osseus-mvp/asimov-1/electrical/README.md

## RPU 
> WIP

## Wiring

WireViz was utilised for representing the wiring harness of the robot. 

Please refer to WireViz documentation for available visualisation options.
### Cable Naming Convention

```
W-<ID>-<TYPE>
ID = unique ID
TYPE = Power (PWR) or Signal (SIG) cable bundle
```
