osseus-mvp/asimov-1/electrical/motion_control/board/MCB-V1.0.step

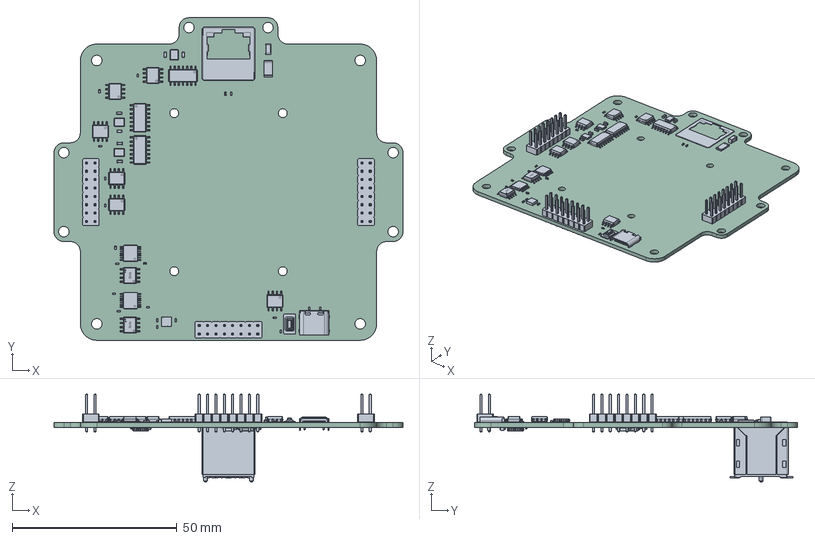
[picture p1: CAD file, 2026-07-03]
electrical/motion_control/board/MCB-V1.0.step
106.0 x 98.0 x 26.7 mm
R_0402_1005Metric x 13
SOIC-8_3.9x4.9mm_P1.27mm x 6
SOIC-14_3.9x8.7mm_P1.27mm x 3
C_0603_1608Metric x 6
SW-SMD_L6.2-W3.7-LS8.0
C_0402_1005Metric x 15
SOIC-8_L4.9-W3.9-H1.7-LS6.0-P1.27 x 2
PinHeader_2x08_P2.54mm_Vertical x 3
C_1206_3216Metric
USB-C-SMD_TYPE-C-6PIN-2MD-073
TSSOP-14_4.4x5mm_P0.65mm x 4
R_2010_5025Metric
DFN-8_L3.0-W3.0-H1.0-P0.50
Crystal_SMD_3225-4Pin_3.2x2.5mm x 3
RJ45-SMD_HR963380AE
LGA-14_L2.5-W3.0-H0.9-P0.50
board_PCB
