osseus-mvp/asimov-1/electrical/power_distribution/board/PDB-V1.0.step

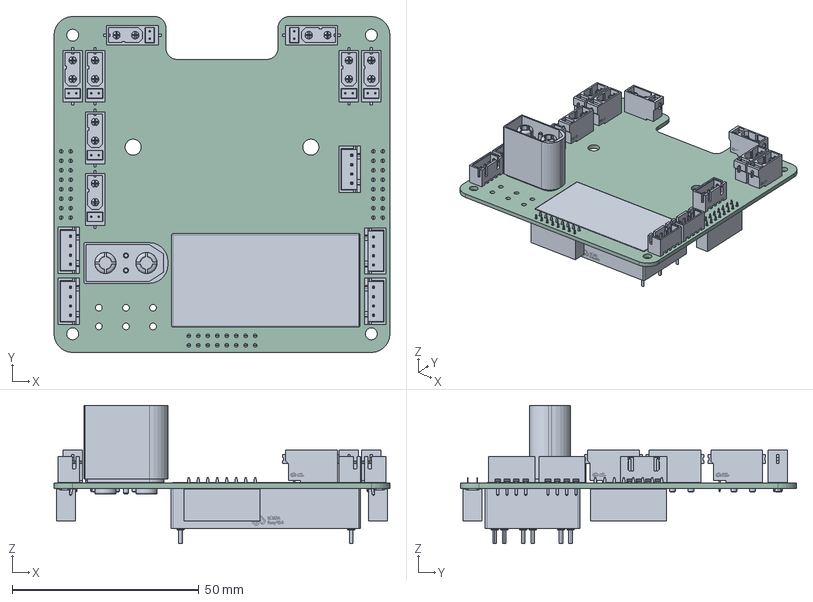
[picture p2: CAD file, 2026-07-03]
electrical/power_distribution/board/PDB-V1.0.step
90.0 x 90.0 x 37.0 mm
CONN-SMD_XT90-2-2-PB-MGY
CONN-TH_XT30PB-M x 8
JST_XH_B4B-XH-A_1x04_P2.50mm_Vertical x 5
PWRM-TH_TURBXXXXLD-30WR3
PinSocket_2x08_P2.54mm_Vertical x 3
board_PCB
