osseus-mvp/asimov-1/sim-model/assets/meshes/ANKLE_B_NEW.STL

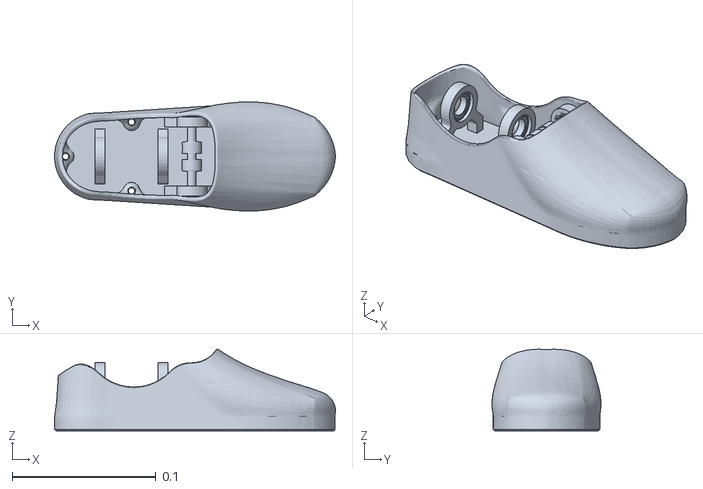
[picture p3: CAD file, 2026-08-17]
sim-model/assets/meshes/ANKLE_B_NEW.STL
0.196 x 0.0761 x 0.0569
