osseus-mvp/asimov-1/(list of files, drawings)

Other design files:
electrical/head_board/head_board.epro
