osseus-mvp/asimov-1/electrical/power_distribution/board/board.kicad_pcb

## KiCad design electrical/power_distribution/board/board.kicad_pcb (2026-07-03)

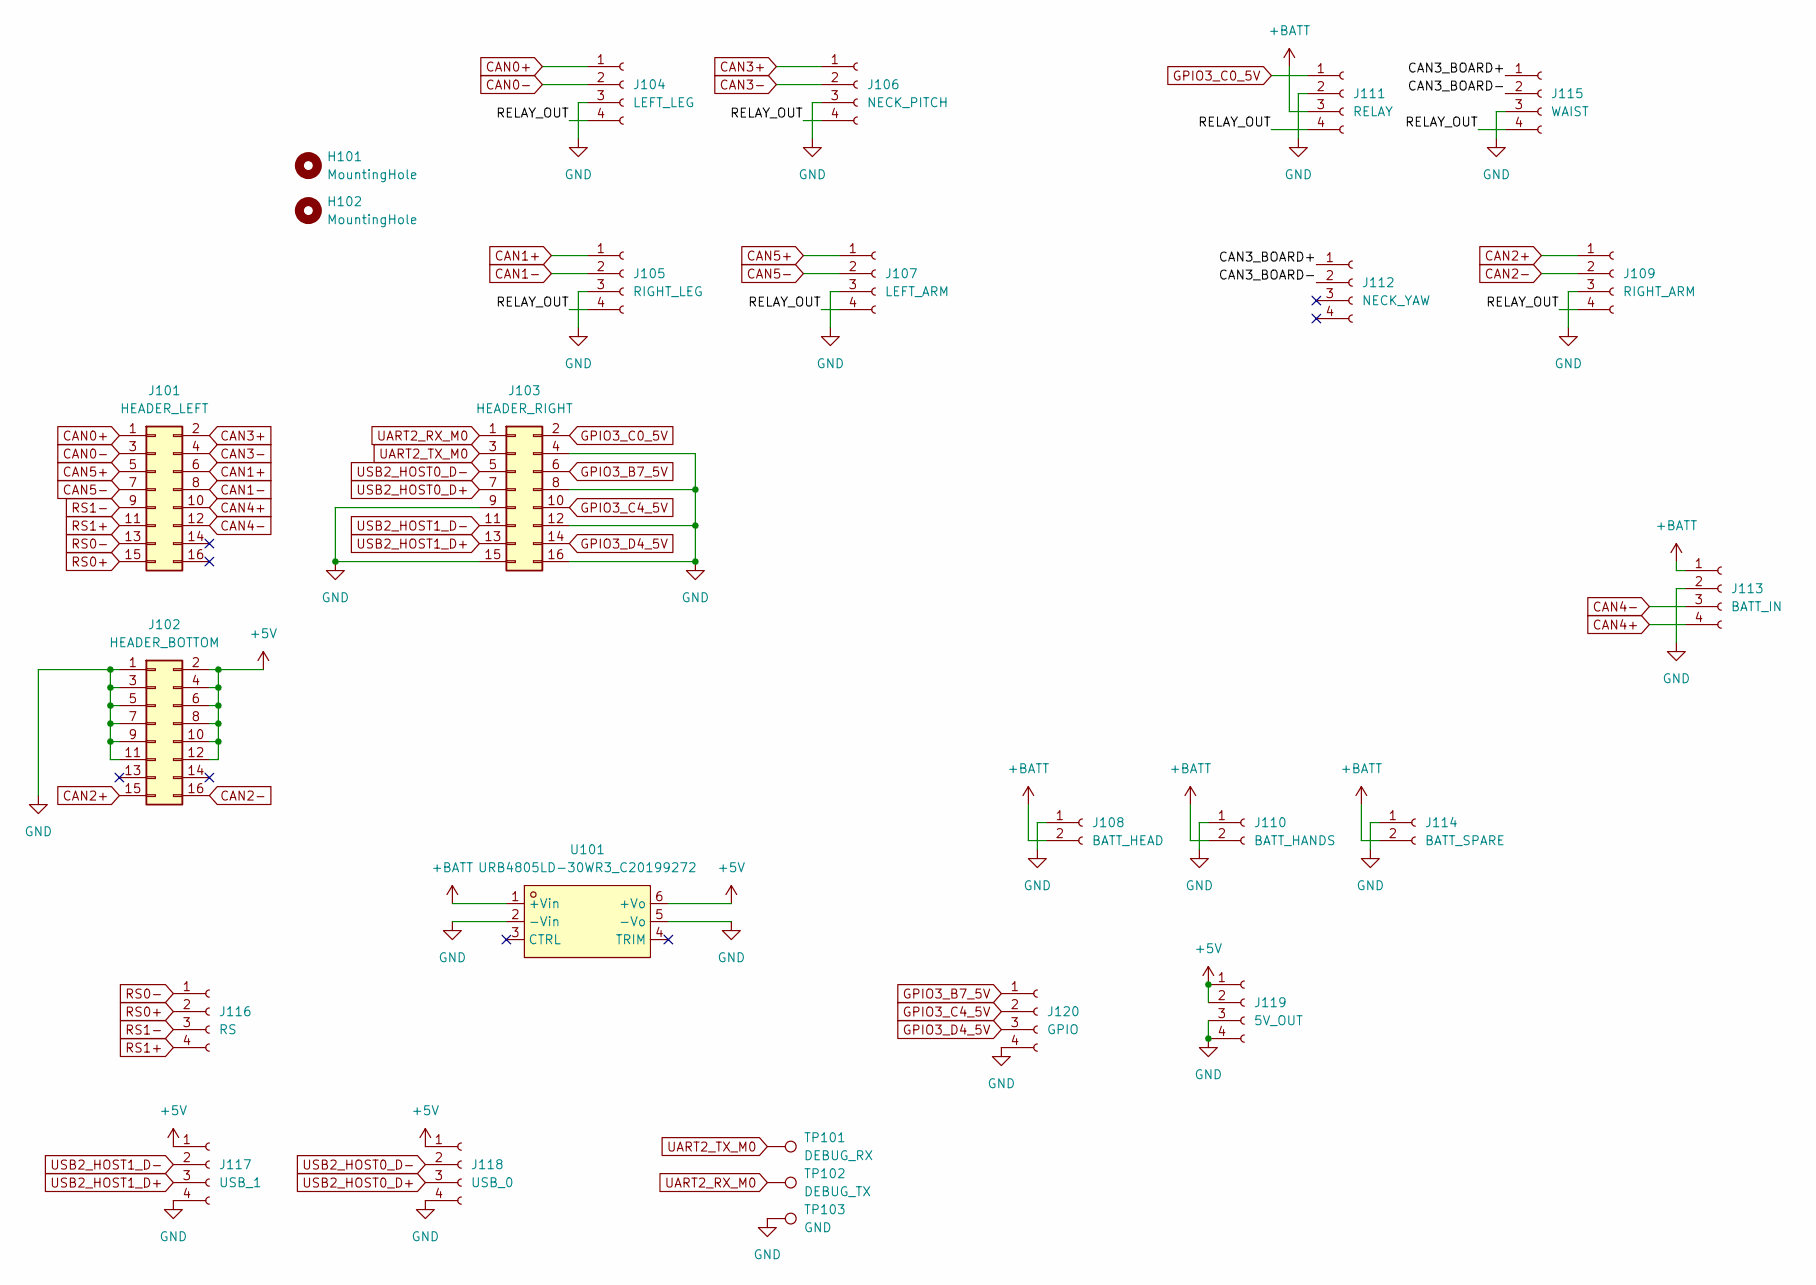
[picture p4: schematic board.kicad_sch]

Parts:
H101, H102: MountingHole; MountingHole_4.3mm_M4
J101: HEADER_LEFT; PinSocket_2x08_P2.54mm_Vertical; LCSC C30734
J102: HEADER_BOTTOM; PinSocket_2x08_P2.54mm_Vertical; LCSC C30734
J103: HEADER_RIGHT; PinSocket_2x08_P2.54mm_Vertical; LCSC C30734
J104: LEFT_LEG; CONN-TH_XT30PB-M
J105: RIGHT_LEG; CONN-TH_XT30PB-M
J106: NECK_PITCH; CONN-TH_XT30PB-M
J107: LEFT_ARM; CONN-TH_XT30PB-M
J108: BATT_HEAD; AMASS_XT30UPB-F_1x02_P5.0mm_Vertical; LCSC C108769
J109: RIGHT_ARM; CONN-TH_XT30PB-M
J110: BATT_HANDS; AMASS_XT30UPB-F_1x02_P5.0mm_Vertical; LCSC C108769
J111: RELAY; CONN-TH_XT30PB-M
J112: NECK_YAW; CONN-TH_XT30PB-M
J113: BATT_IN; CONN-SMD_XT90-2-2-PB-MGY; LCSC C19268046
J114: BATT_SPARE; AMASS_XT30UPB-F_1x02_P5.0mm_Vertical; LCSC C108769
J115: WAIST; CONN-TH_XT30PB-M
J116: RS; JST_XH_B4B-XH-A_1x04_P2.50mm_Vertical; LCSC C144395
J117: USB_1; JST_XH_B4B-XH-A_1x04_P2.50mm_Vertical; LCSC C144395
J118: USB_0; JST_XH_B4B-XH-A_1x04_P2.50mm_Vertical; LCSC C144395
J119: 5V_OUT; JST_XH_B4B-XH-A_1x04_P2.50mm_Vertical; LCSC C144395
J120: GPIO; JST_XH_B4B-XH-A_1x04_P2.50mm_Vertical; LCSC C144395
TP101: DEBUG_RX; TestPoint_Pad_D1.0mm
TP102: DEBUG_TX; TestPoint_Pad_D1.0mm
TP103: GND; TestPoint_Pad_D1.0mm
U101: URB4805LD-30WR3_C20199272; PWRM-TH_TURBXXXXLD-30WR3; MPN URB4805LD-30WR3; LCSC Part C20199272

Connections:
+5V: J102.2, J102.4, J102.6, J102.8, J102.10, J102.12, J117.1, J118.1, J119.1, J119.2, U101.6 (+Vo)
+BATT: J108.2, J110.2, J111.3, J113.1, J114.2, U101.1 (+Vin)
/CAN3_BOARD+: J112.1, J115.1
/CAN3_BOARD-: J112.2, J115.2
/RELAY_OUT: J104.4, J105.4, J106.4, J107.4, J109.4, J111.4, J115.4
CAN0+: J101.1, J104.1
CAN0-: J101.3, J104.2
CAN1+: J101.6, J105.1
CAN1-: J101.8, J105.2
CAN2+: J102.15, J109.1
CAN2-: J102.16, J109.2
CAN3+: J101.2, J106.1
CAN3-: J101.4, J106.2
CAN4+: J101.10, J113.4
CAN4-: J101.12, J113.3
CAN5+: J101.5, J107.1
CAN5-: J101.7, J107.2
GND: J102.1, J102.3, J102.5, J102.7, J102.9, J102.11, J103.4, J103.8, J103.9, J103.12, J103.15, J103.16, J104.3, J105.3, J106.3, J107.3, J108.1, J109.3, J110.1, J111.2, J113.2, J114.1, J115.3, J117.4, J118.4, J119.3, J119.4, J120.4, TP103.1 (1_1), U101.2 (-Vin), U101.5 (-Vo)
GPIO3_B7_5V: J103.6, J120.1
GPIO3_C0_5V: J103.2, J111.1
GPIO3_C4_5V: J103.10, J120.2
GPIO3_D4_5V: J103.14, J120.3
RS0+: J101.15, J116.2
RS0-: J101.13, J116.1
RS1+: J101.11, J116.4
RS1-: J101.9, J116.3
UART2_RX_M0: J103.1, TP102.1 (1_1)
UART2_TX_M0: J103.3, TP101.1 (1_1)
USB2_HOST0_D+: J103.7, J118.3
USB2_HOST0_D-: J103.5, J118.2
USB2_HOST1_D+: J103.13, J117.3
USB2_HOST1_D-: J103.11, J117.2

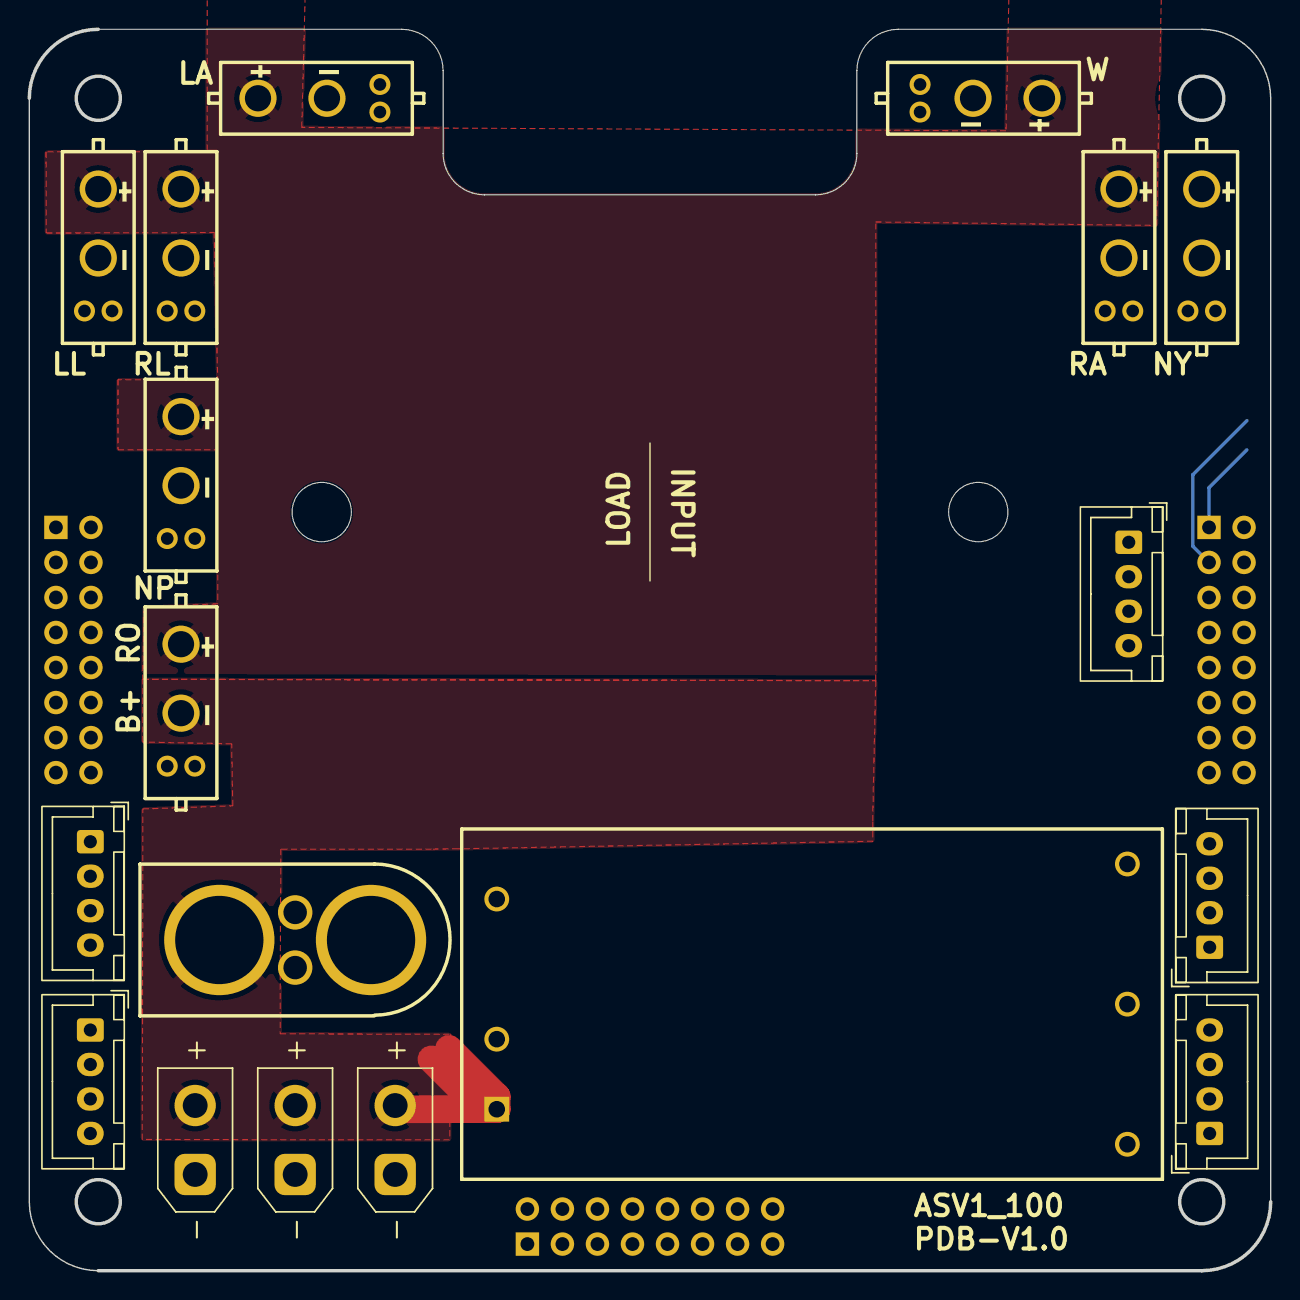
[picture p5: board electrical/power_distribution/board/board.kicad_pcb from above]

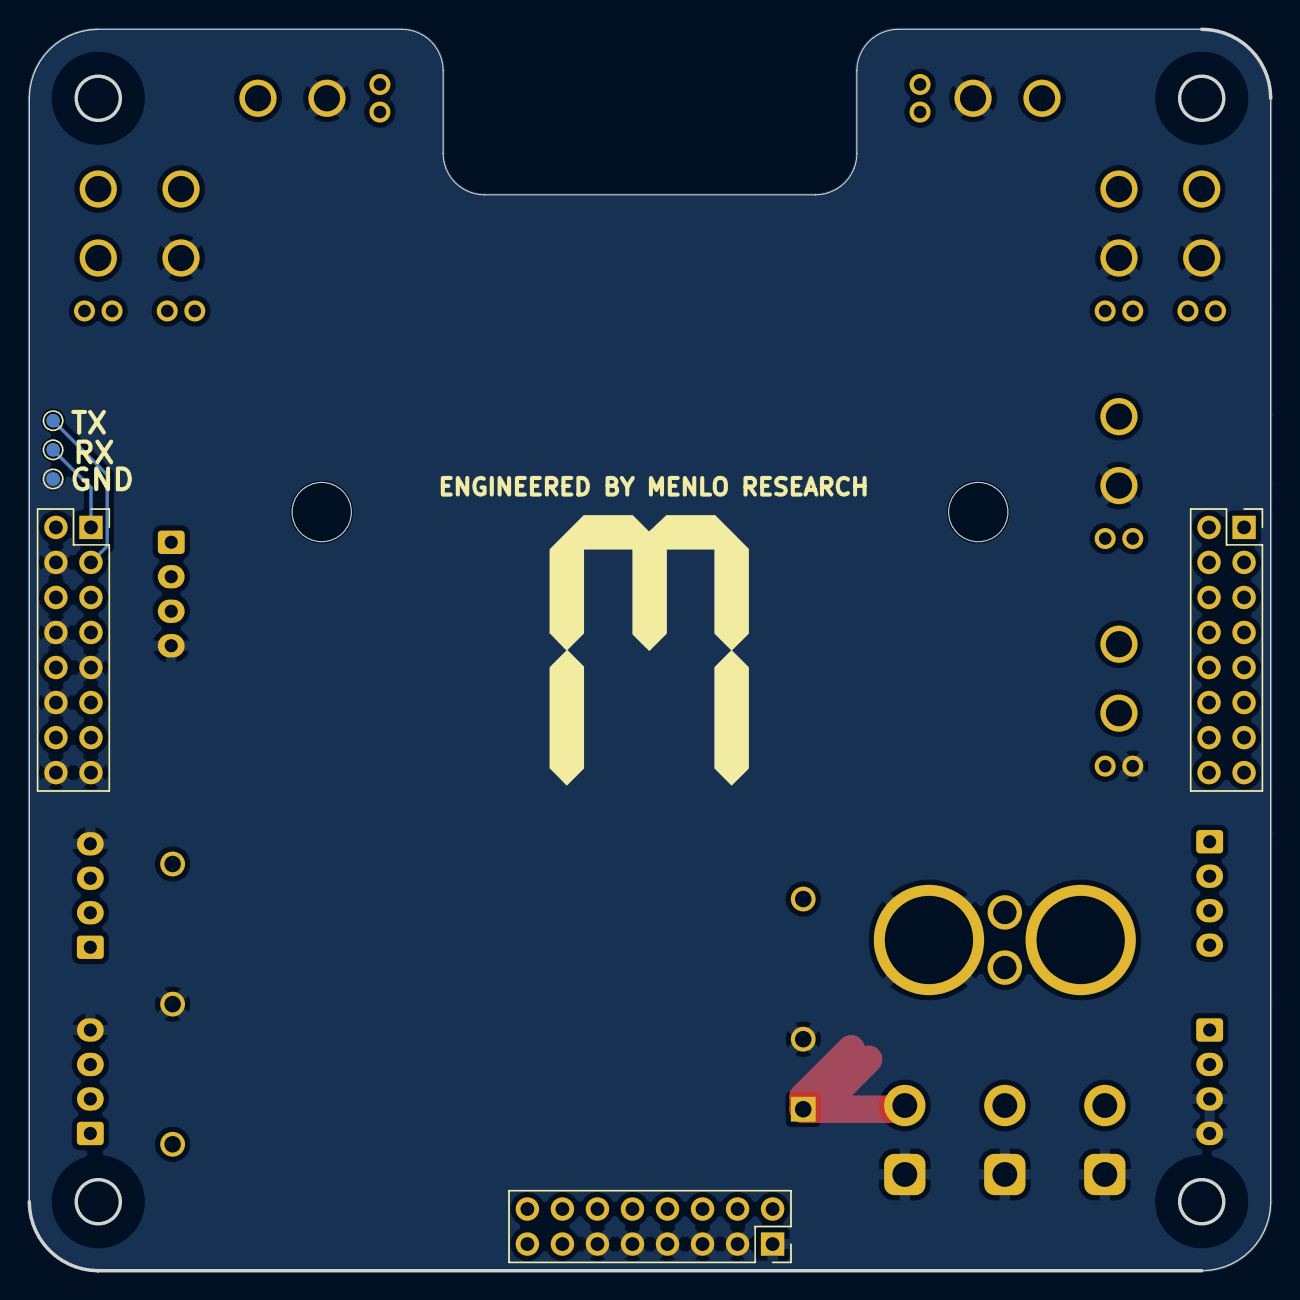
[picture p6: board electrical/power_distribution/board/board.kicad_pcb from below]

Board: 4 copper layers, 90.0 x 90.0 mm, 26 parts (6 on the bottom side), 32 nets.
