osseus-mvp/asimov-1/electrical/motion_control/board/board.kicad_pcb

## KiCad design electrical/motion_control/board/board.kicad_pcb (2026-07-03)

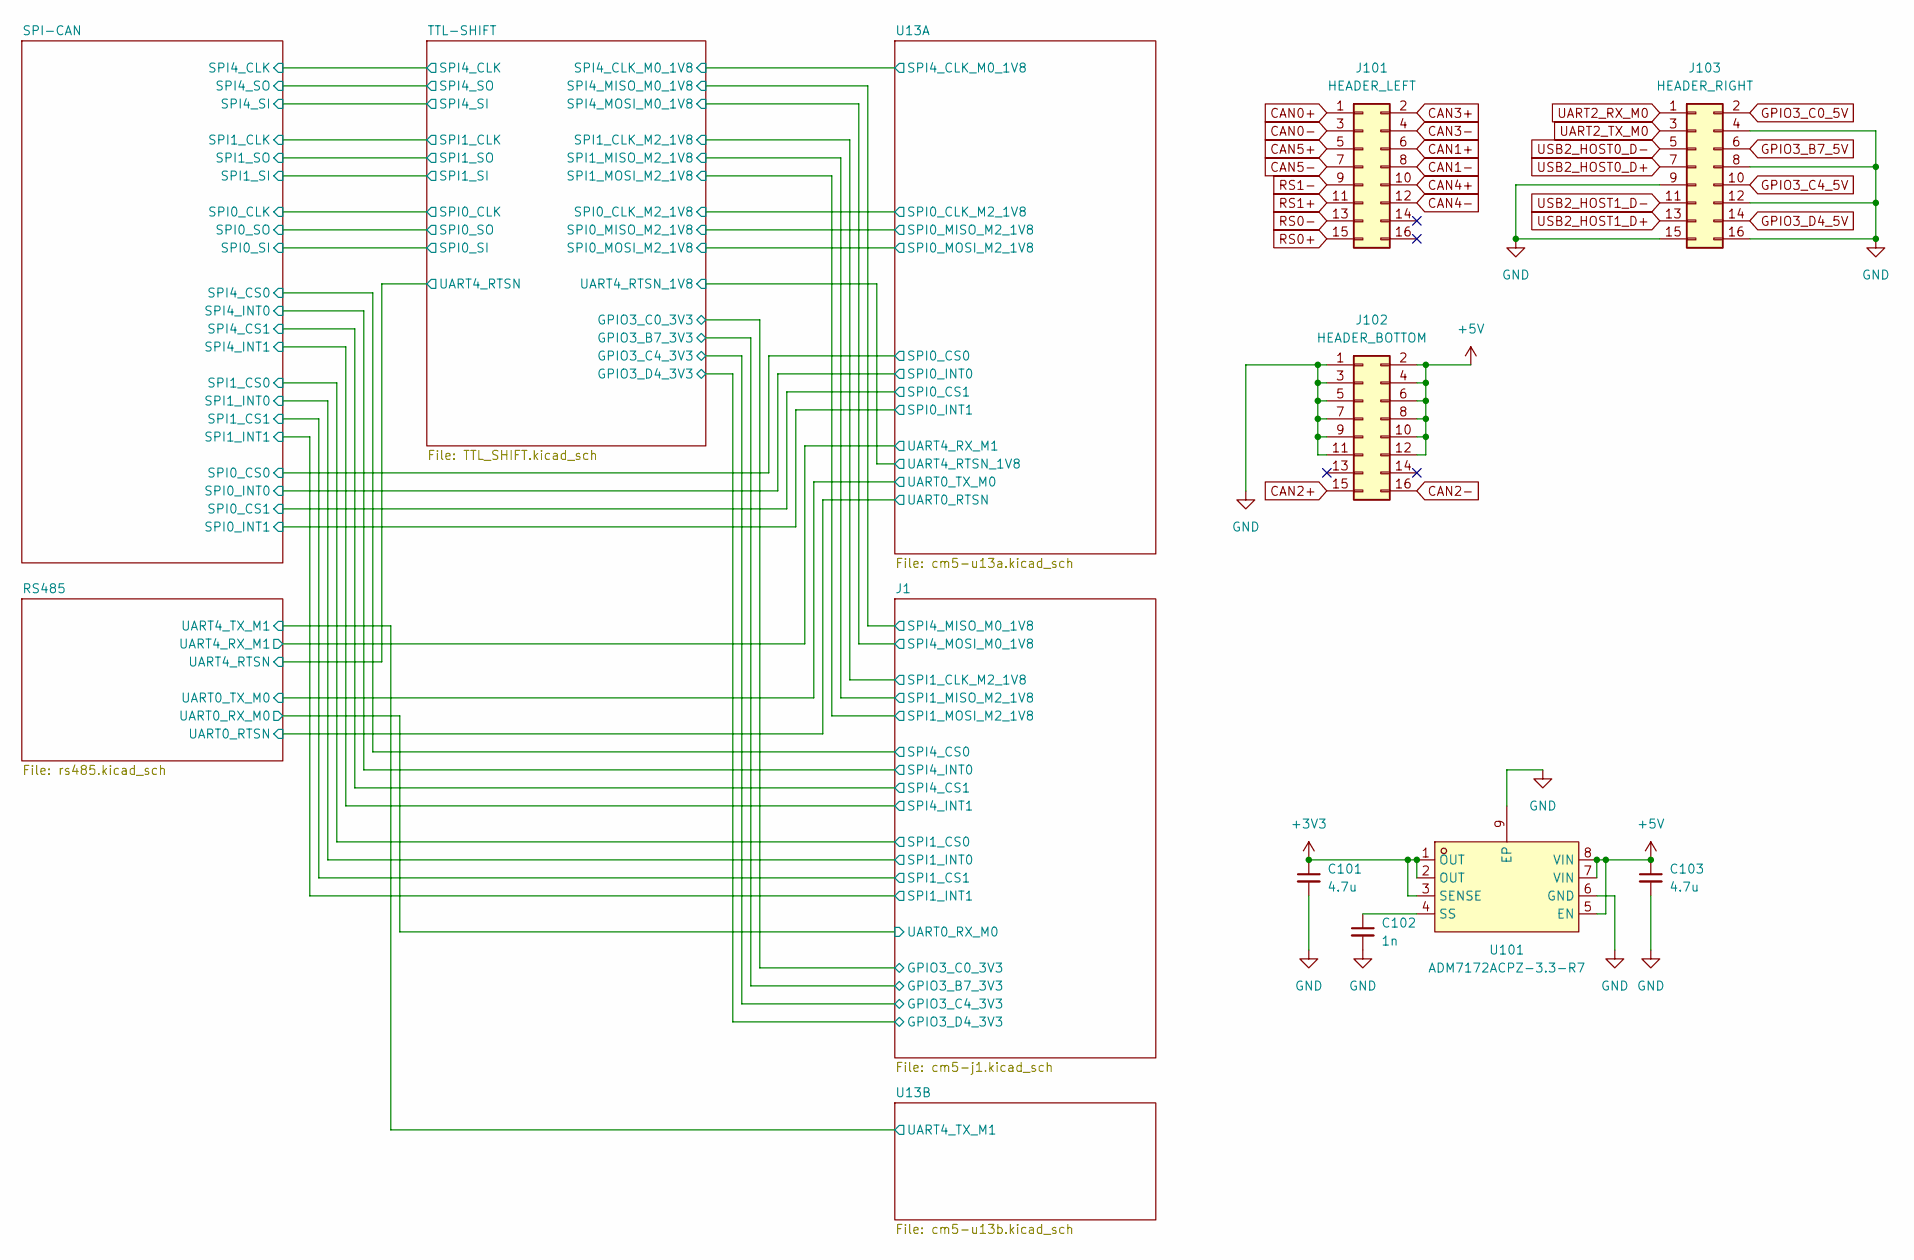
[picture p7: schematic board.kicad_sch]

Parts:
C101, C103: 4.7u; C_0402_1005Metric; LCSC C368809
C102: 1n; C_0402_1005Metric; LCSC C76947
J101: HEADER_LEFT; PinHeader_2x08_P2.54mm_Vertical; LCSC C492425
J102: HEADER_BOTTOM; PinHeader_2x08_P2.54mm_Vertical; LCSC C492425
J103: HEADER_RIGHT; PinHeader_2x08_P2.54mm_Vertical; LCSC C492425
U101: ADM7172ACPZ-3.3-R7; DFN-8_L3.0-W3.0-P0.50-BL-EP; MPN ADM7172ACPZ-3.3-R7; LCSC Part C514342

Connections:
+3V3: C101.1, U101.1 (OUT), U101.2 (OUT), U101.3 (SENSE); also elsewhere on the board
+5V: C103.1, J102.2, J102.4, J102.6, J102.8, J102.10, J102.12, U101.5 (EN), U101.7 (VIN), U101.8 (VIN); also elsewhere on the board
CAN0+: J101.1; also elsewhere on the board
CAN0-: J101.3; also elsewhere on the board
CAN1+: J101.6; also elsewhere on the board
CAN1-: J101.8; also elsewhere on the board
CAN2+: J102.15; also elsewhere on the board
CAN2-: J102.16; also elsewhere on the board
CAN3+: J101.2; also elsewhere on the board
CAN3-: J101.4; also elsewhere on the board
CAN4+: J101.10; also elsewhere on the board
CAN4-: J101.12; also elsewhere on the board
CAN5+: J101.5; also elsewhere on the board
CAN5-: J101.7; also elsewhere on the board
GND: C101.2, C102.2, C103.2, J102.1, J102.3, J102.5, J102.7, J102.9, J102.11, J103.4, J103.8, J103.9, J103.12, J103.15, J103.16, U101.6 (GND), U101.9 (EP); also elsewhere on the board
GPIO3_B7_5V: J103.6; also elsewhere on the board
GPIO3_C0_5V: J103.2; also elsewhere on the board
GPIO3_C4_5V: J103.10; also elsewhere on the board
GPIO3_D4_5V: J103.14; also elsewhere on the board
unnamed: C102.1, U101.4 (SS)
RS0+: J101.15; also elsewhere on the board
RS0-: J101.13; also elsewhere on the board
RS1+: J101.11; also elsewhere on the board
RS1-: J101.9; also elsewhere on the board
UART2_RX_M0: J103.1; also elsewhere on the board
UART2_TX_M0: J103.3; also elsewhere on the board
USB2_HOST0_D+: J103.7; also elsewhere on the board
USB2_HOST0_D-: J103.5; also elsewhere on the board
USB2_HOST1_D+: J103.13; also elsewhere on the board
USB2_HOST1_D-: J103.11; also elsewhere on the board

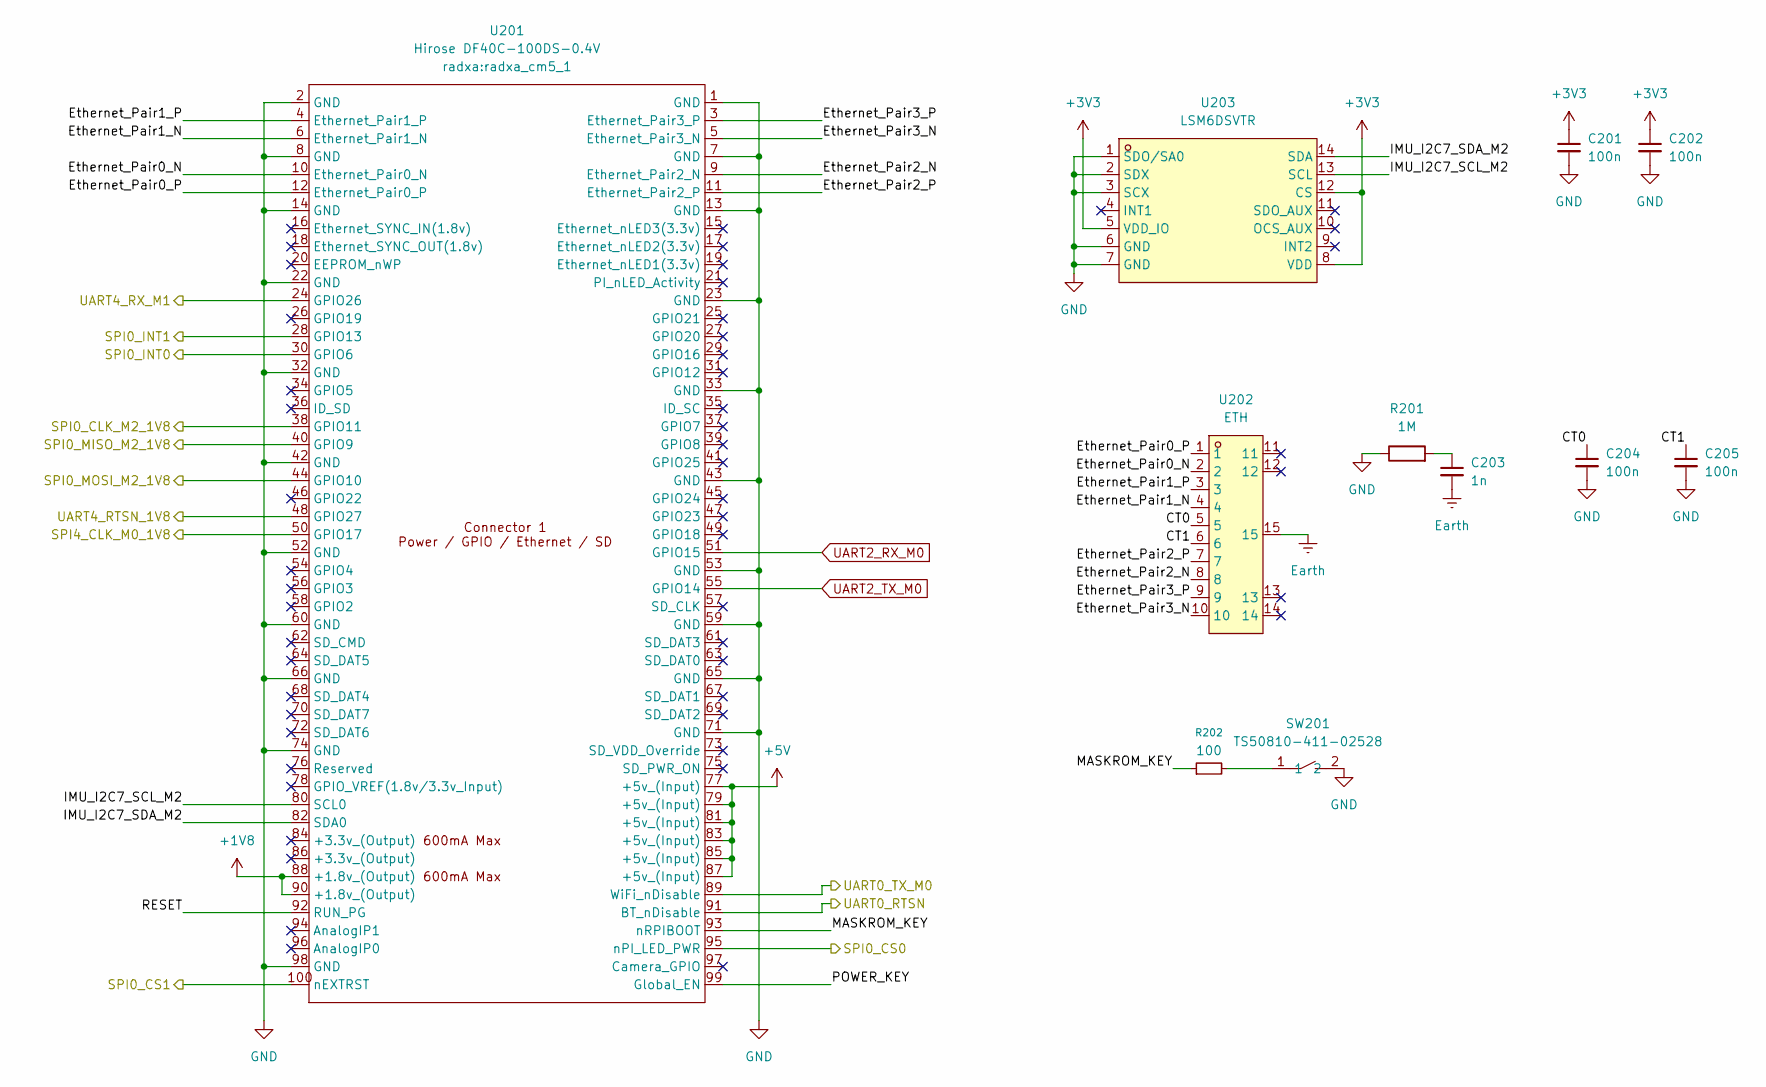
[picture p8: schematic cm5-u13a.kicad_sch]

Parts:
C201, C202: 100n; C_0402_1005Metric; LCSC C77020
C203: 1n; C_1206_3216Metric; LCSC C23631
C204, C205: 100n; C_0402_1005Metric; LCSC C541464
R201: 1M; R_2010_5025Metric; LCSC C1513439
R202: 100; R_0402_1005Metric; LCSC C106232
SW201: TS50810-411-02528; SW-SMD_L6.2-W3.7-LS8.0; MPN TS50810-411-02528; LCSC Part C42400876
U201: Hirose DF40C-100DS-0.4V; radxa_cm5_1; LCSC C597931
U202: ETH; RJ45-SMD_HR963380AE; MPN HR963380AE; LCSC Part C19724763
U203: LSM6DSVTR; LGA-14_L3.0-W2.5-P0.50-TL; LCSC Part C5267399

Connections:
+1V8: U201.88 (+1.8v_(Output)), U201.90 (+1.8v_(Output)); also elsewhere on the board
+3V3: C201.1, C202.1, U203.5 (VDD_IO), U203.8 (VDD), U203.12 (CS); also elsewhere on the board
+5V: U201.77 (+5v_(Input)), U201.79 (+5v_(Input)), U201.81 (+5v_(Input)), U201.83 (+5v_(Input)), U201.85 (+5v_(Input)), U201.87 (+5v_(Input)); also elsewhere on the board
/RS485/UART0_RTSN: U201.91 (BT_nDisable); also elsewhere on the board
/RS485/UART0_TX_M0: U201.89 (WiFi_nDisable); also elsewhere on the board
/RS485/UART4_RX_M1: U201.24 (GPIO26); also elsewhere on the board
/SPI-CAN/SPI0_CS0: U201.95 (nPI_LED_PWR); also elsewhere on the board
/SPI-CAN/SPI0_CS1: U201.100 (nEXTRST); also elsewhere on the board
/SPI-CAN/SPI0_INT0: U201.30 (GPIO6); also elsewhere on the board
/SPI-CAN/SPI0_INT1: U201.28 (GPIO13); also elsewhere on the board
/TTL-SHIFT/SPI0_CLK_M2_1V8: U201.38 (GPIO11); also elsewhere on the board
/TTL-SHIFT/SPI0_MISO_M2_1V8: U201.40 (GPIO9); also elsewhere on the board
/TTL-SHIFT/SPI0_MOSI_M2_1V8: U201.44 (GPIO10); also elsewhere on the board
/TTL-SHIFT/SPI4_CLK_M0_1V8: U201.50 (GPIO17); also elsewhere on the board
/TTL-SHIFT/UART4_RTSN_1V8: U201.48 (GPIO27); also elsewhere on the board
/U13A/CT0: C204.1, U202.5
/U13A/CT1: C205.1, U202.6
/U13A/Ethernet_Pair0_N: U201.10 (Ethernet_Pair0_N), U202.2
/U13A/Ethernet_Pair0_P: U201.12 (Ethernet_Pair0_P), U202.1
/U13A/Ethernet_Pair1_N: U201.6 (Ethernet_Pair1_N), U202.4
/U13A/Ethernet_Pair1_P: U201.4 (Ethernet_Pair1_P), U202.3
/U13A/Ethernet_Pair2_N: U201.9 (Ethernet_Pair2_N), U202.8
/U13A/Ethernet_Pair2_P: U201.11 (Ethernet_Pair2_P), U202.7
/U13A/Ethernet_Pair3_N: U201.5 (Ethernet_Pair3_N), U202.10
/U13A/Ethernet_Pair3_P: U201.3 (Ethernet_Pair3_P), U202.9
/U13A/IMU_I2C7_SCL_M2: U201.80 (SCL0), U203.13 (SCL)
/U13A/IMU_I2C7_SDA_M2: U201.82 (SDA0), U203.14 (SDA)
/U13A/MASKROM_KEY: R202.1, U201.93 (nRPIBOOT)
/U13A/POWER_KEY: U201.99 (Global_EN)
/U13A/RESET: U201.92 (RUN_PG)
Earth: C203.2, U202.15
GND: C201.2, C202.2, C204.2, C205.2, R201.1, SW201.2, U201.1 (GND), U201.2 (GND), U201.7 (GND), U201.8 (GND), U201.13 (GND), U201.14 (GND), U201.22 (GND), U201.23 (GND), U201.32 (GND), U201.33 (GND), U201.42 (GND), U201.43 (GND), U201.52 (GND), U201.53 (GND), U201.59 (GND), U201.60 (GND), U201.65 (GND), U201.66 (GND), U201.71 (GND), U201.74 (GND), U201.98 (GND), U203.1 (SDO/SA0), U203.2 (SDX), U203.3 (SCX), U203.6 (GND), U203.7 (GND); also elsewhere on the board
unnamed: C203.1, R201.2
unnamed: R202.2, SW201.1
UART2_RX_M0: U201.51 (GPIO15); also elsewhere on the board
UART2_TX_M0: U201.55 (GPIO14); also elsewhere on the board

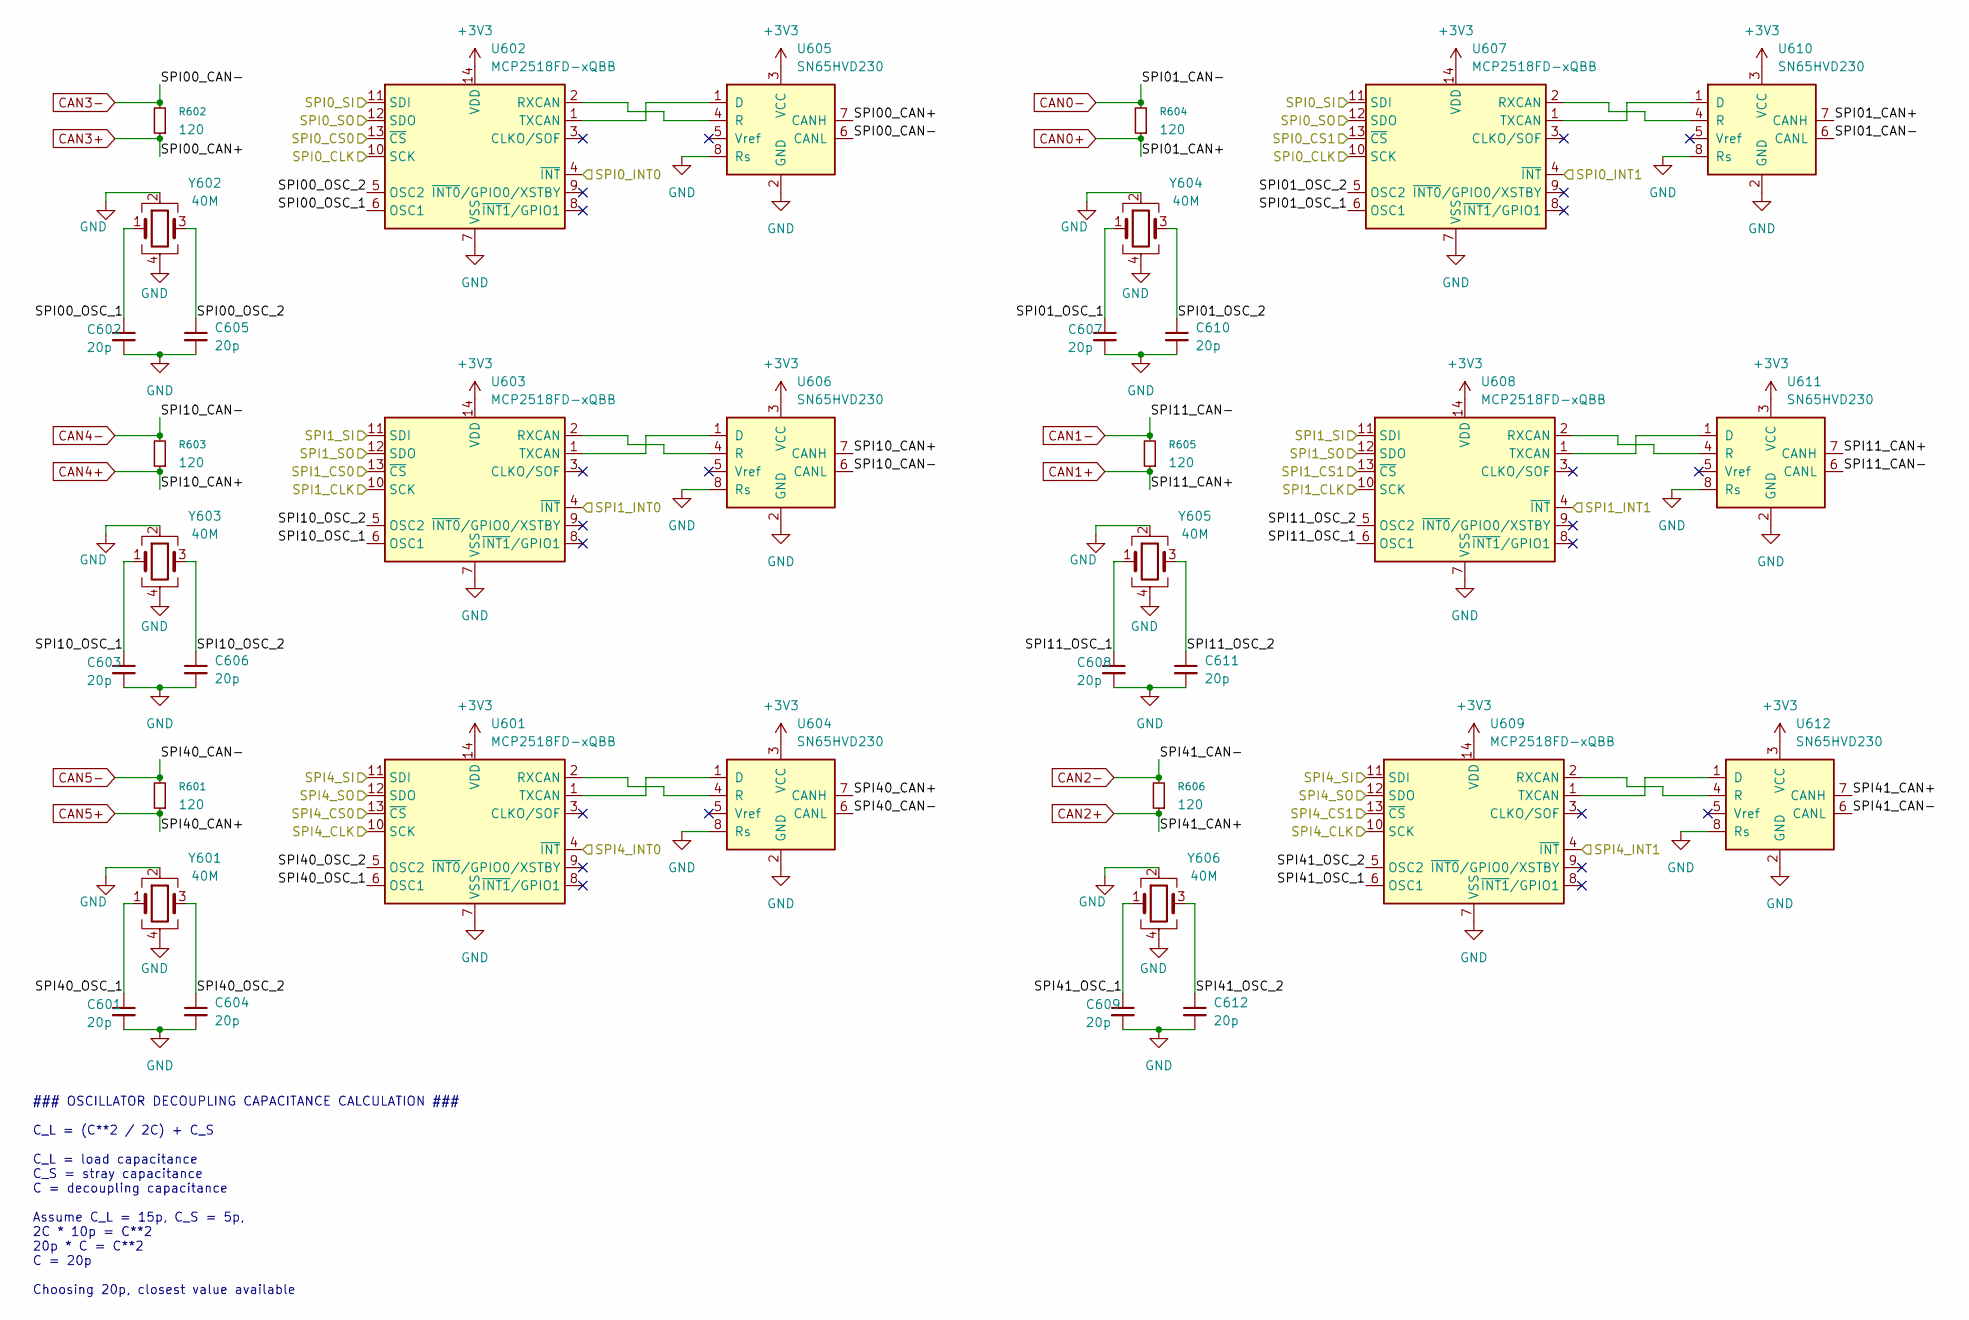
[picture p9: schematic spi-can.kicad_sch]

Parts:
C601, C602, C603, C604, C605, C606, C607, C608, C609, C610, C611, C612: 20p; C_0603_1608Metric; LCSC C165732
R601, R602, R603, R604, R605, R606: 120; R_0402_1005Metric; LCSC C114758
U601, U602, U603, U607, U608, U609: MCP2518FD-xQBB; SOIC-14_3.9x8.7mm_P1.27mm; LCSC C626758
U604, U605, U606, U610, U611, U612: SN65HVD230; SOIC-8_3.9x4.9mm_P1.27mm; LCSC C12084
Y601, Y602, Y603, Y604, Y605, Y606: 40M; Crystal_SMD_3225-4Pin_3.2x2.5mm; LCSC C5444549

Connections:
+3V3: U601.14 (VDD), U602.14 (VDD), U603.14 (VDD), U604.3 (VCC), U605.3 (VCC), U606.3 (VCC), U607.14 (VDD), U608.14 (VDD), U609.14 (VDD), U610.3 (VCC), U611.3 (VCC), U612.3 (VCC); also elsewhere on the board
/J1/SPI1_CS0: U603.13 (~CS); also elsewhere on the board
/J1/SPI1_CS1: U608.13 (~CS); also elsewhere on the board
/J1/SPI1_INT0: U603.4 (~INT); also elsewhere on the board
/J1/SPI1_INT1: U608.4 (~INT); also elsewhere on the board
/J1/SPI4_CS0: U601.13 (~CS); also elsewhere on the board
/J1/SPI4_CS1: U609.13 (~CS); also elsewhere on the board
/J1/SPI4_INT0: U601.4 (~INT); also elsewhere on the board
/J1/SPI4_INT1: U609.4 (~INT); also elsewhere on the board
/SPI-CAN/SPI0_CLK: U602.10 (SCK), U607.10 (SCK); also elsewhere on the board
/SPI-CAN/SPI0_CS0: U602.13 (~CS); also elsewhere on the board
/SPI-CAN/SPI0_CS1: U607.13 (~CS); also elsewhere on the board
/SPI-CAN/SPI0_INT0: U602.4 (~INT); also elsewhere on the board
/SPI-CAN/SPI0_INT1: U607.4 (~INT); also elsewhere on the board
/SPI-CAN/SPI00_OSC_1: C602.1, U602.6 (OSC1), Y602.1
/SPI-CAN/SPI00_OSC_2: C605.1, U602.5 (OSC2), Y602.3
/SPI-CAN/SPI0_SI: U602.11 (SDI), U607.11 (SDI); also elsewhere on the board
/SPI-CAN/SPI0_SO: U602.12 (SDO), U607.12 (SDO); also elsewhere on the board
/SPI-CAN/SPI1_CLK: U603.10 (SCK), U608.10 (SCK); also elsewhere on the board
/SPI-CAN/SPI01_OSC_1: C607.1, U607.6 (OSC1), Y604.1
/SPI-CAN/SPI01_OSC_2: C610.1, U607.5 (OSC2), Y604.3
/SPI-CAN/SPI1_SI: U603.11 (SDI), U608.11 (SDI); also elsewhere on the board
/SPI-CAN/SPI1_SO: U603.12 (SDO), U608.12 (SDO); also elsewhere on the board
/SPI-CAN/SPI4_CLK: U601.10 (SCK), U609.10 (SCK); also elsewhere on the board
/SPI-CAN/SPI4_SI: U601.11 (SDI), U609.11 (SDI); also elsewhere on the board
/SPI-CAN/SPI4_SO: U601.12 (SDO), U609.12 (SDO); also elsewhere on the board
/SPI-CAN/SPI10_OSC_1: C603.1, U603.6 (OSC1), Y603.1
/SPI-CAN/SPI10_OSC_2: C606.1, U603.5 (OSC2), Y603.3
/SPI-CAN/SPI11_OSC_1: C608.1, U608.6 (OSC1), Y605.1
/SPI-CAN/SPI11_OSC_2: C611.1, U608.5 (OSC2), Y605.3
/SPI-CAN/SPI40_OSC_1: C601.1, U601.6 (OSC1), Y601.1
/SPI-CAN/SPI40_OSC_2: C604.1, U601.5 (OSC2), Y601.3
/SPI-CAN/SPI41_OSC_1: C609.1, U609.6 (OSC1), Y606.1
/SPI-CAN/SPI41_OSC_2: C612.1, U609.5 (OSC2), Y606.3
CAN0+: R604.1, U610.7 (CANH); also elsewhere on the board
CAN0-: R604.2, U610.6 (CANL); also elsewhere on the board
CAN1+: R605.1, U611.7 (CANH); also elsewhere on the board
CAN1-: R605.2, U611.6 (CANL); also elsewhere on the board
CAN2+: R606.1, U612.7 (CANH); also elsewhere on the board
CAN2-: R606.2, U612.6 (CANL); also elsewhere on the board
CAN3+: R602.1, U605.7 (CANH); also elsewhere on the board
CAN3-: R602.2, U605.6 (CANL); also elsewhere on the board
CAN4+: R603.1, U606.7 (CANH); also elsewhere on the board
CAN4-: R603.2, U606.6 (CANL); also elsewhere on the board
CAN5+: R601.1, U604.7 (CANH); also elsewhere on the board
CAN5-: R601.2, U604.6 (CANL); also elsewhere on the board
GND: C601.2, C602.2, C603.2, C604.2, C605.2, C606.2, C607.2, C608.2, C609.2, C610.2, C611.2, C612.2, U601.7 (VSS), U601.15 (VSS), U602.7 (VSS), U602.15 (VSS), U603.7 (VSS), U603.15 (VSS), U604.2 (GND), U604.8 (Rs), U605.2 (GND), U605.8 (Rs), U606.2 (GND), U606.8 (Rs), U607.7 (VSS), U607.15 (VSS), U608.7 (VSS), U608.15 (VSS), U609.7 (VSS), U609.15 (VSS), U610.2 (GND), U610.8 (Rs), U611.2 (GND), U611.8 (Rs), U612.2 (GND), U612.8 (Rs), Y601.2, Y601.4, Y602.2, Y602.4, Y603.2, Y603.4, Y604.2, Y604.4, Y605.2, Y605.4, Y606.2, Y606.4; also elsewhere on the board
unnamed: U601.2 (RXCAN), U604.4 (R)
unnamed: U601.1 (TXCAN), U604.1 (D)
unnamed: U602.2 (RXCAN), U605.4 (R)
unnamed: U602.1 (TXCAN), U605.1 (D)
unnamed: U603.2 (RXCAN), U606.4 (R)
unnamed: U603.1 (TXCAN), U606.1 (D)
unnamed: U607.2 (RXCAN), U610.4 (R)
unnamed: U607.1 (TXCAN), U610.1 (D)
unnamed: U608.2 (RXCAN), U611.4 (R)
unnamed: U608.1 (TXCAN), U611.1 (D)
unnamed: U609.2 (RXCAN), U612.4 (R)
unnamed: U609.1 (TXCAN), U612.1 (D)

Notes on the sheet:
### OSCILLATOR DECOUPLING CAPACITANCE CALCULATION ### C_L = (C**2 / 2C) + C_S C_L = load capacitance C_S = stray capacitance C = decoupling capacitance Assume C_L = 15p, C_S = 5p, 2C * 10p = C**2 20p * C = C**2 C = 20p Choosing 20p, closest value available
