osseus-mvp/asimov-1/electrical/motion_control/board/board.kicad_pcb

## KiCad design electrical/motion_control/board/board.kicad_pcb (continued)

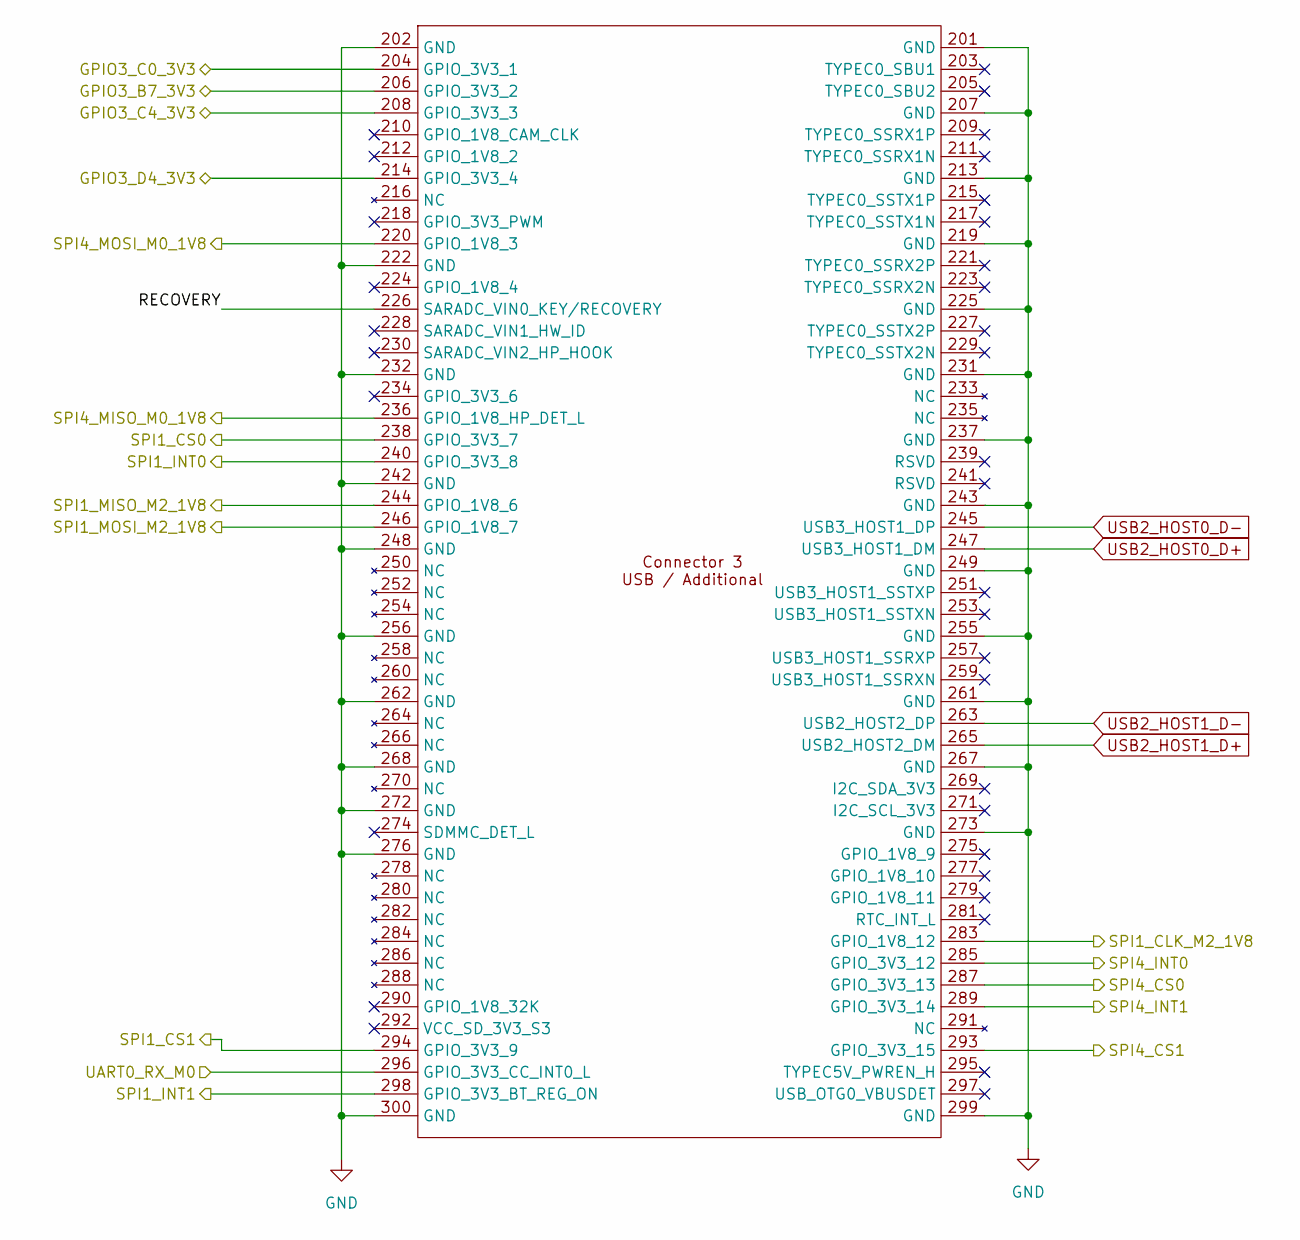
[picture p10: schematic cm5-j1.kicad_sch]

Parts:
U401: Hirose DF40C-100DS-0.4V; radxa_cm5_3; LCSC C597931

Connections:
/J1/GPIO3_B7_3V3: U401.206 (GPIO_3V3_2); also elsewhere on the board
/J1/GPIO3_C0_3V3: U401.204 (GPIO_3V3_1); also elsewhere on the board
/J1/GPIO3_C4_3V3: U401.208 (GPIO_3V3_3); also elsewhere on the board
/J1/GPIO3_D4_3V3: U401.214 (GPIO_3V3_4); also elsewhere on the board
/J1/RECOVERY: U401.226 (SARADC_VIN0_KEY/RECOVERY)
/J1/SPI1_CLK_M2_1V8: U401.283 (GPIO_1V8_12); also elsewhere on the board
/J1/SPI1_CS0: U401.238 (GPIO_3V3_7); also elsewhere on the board
/J1/SPI1_CS1: U401.294 (GPIO_3V3_9); also elsewhere on the board
/J1/SPI1_INT0: U401.240 (GPIO_3V3_8); also elsewhere on the board
/J1/SPI1_INT1: U401.298 (GPIO_3V3_BT_REG_ON); also elsewhere on the board
/J1/SPI1_MISO_M2_1V8: U401.244 (GPIO_1V8_6); also elsewhere on the board
/J1/SPI1_MOSI_M2_1V8: U401.246 (GPIO_1V8_7); also elsewhere on the board
/J1/SPI4_CS0: U401.287 (GPIO_3V3_13); also elsewhere on the board
/J1/SPI4_CS1: U401.293 (GPIO_3V3_15); also elsewhere on the board
/J1/SPI4_INT0: U401.285 (GPIO_3V3_12); also elsewhere on the board
/J1/SPI4_INT1: U401.289 (GPIO_3V3_14); also elsewhere on the board
/J1/SPI4_MISO_M0_1V8: U401.236 (GPIO_1V8_HP_DET_L); also elsewhere on the board
/J1/SPI4_MOSI_M0_1V8: U401.220 (GPIO_1V8_3); also elsewhere on the board
/J1/UART0_RX_M0: U401.296 (GPIO_3V3_CC_INT0_L); also elsewhere on the board
GND: U401.201 (GND), U401.202 (GND), U401.207 (GND), U401.213 (GND), U401.219 (GND), U401.222 (GND), U401.225 (GND), U401.231 (GND), U401.232 (GND), U401.237 (GND), U401.242 (GND), U401.243 (GND), U401.248 (GND), U401.249 (GND), U401.255 (GND), U401.256 (GND), U401.261 (GND), U401.262 (GND), U401.267 (GND), U401.268 (GND), U401.272 (GND), U401.273 (GND), U401.276 (GND), U401.299 (GND), U401.300 (GND); also elsewhere on the board
USB2_HOST0_D+: U401.247 (USB3_HOST1_DM); also elsewhere on the board
USB2_HOST0_D-: U401.245 (USB3_HOST1_DP); also elsewhere on the board
USB2_HOST1_D+: U401.265 (USB2_HOST2_DM); also elsewhere on the board
USB2_HOST1_D-: U401.263 (USB2_HOST2_DP); also elsewhere on the board

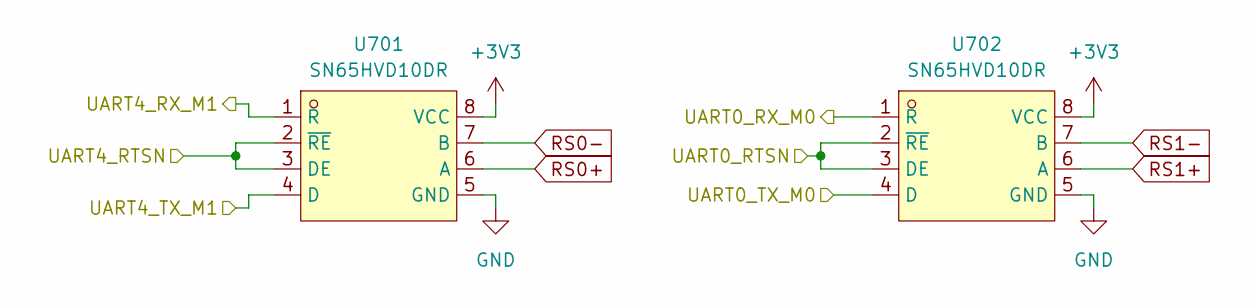
[picture p11: schematic rs485.kicad_sch]

Parts:
U701, U702: SN65HVD10DR; SOIC-8_L4.9-W3.9-P1.27-LS6.0-BL; LCSC Part C148982

Connections:
+3V3: U701.8 (VCC), U702.8 (VCC); also elsewhere on the board
/J1/UART0_RX_M0: U702.1 (R); also elsewhere on the board
/RS485/UART0_RTSN: U702.2 (~RE), U702.3 (DE); also elsewhere on the board
/RS485/UART0_TX_M0: U702.4 (D); also elsewhere on the board
/RS485/UART4_RTSN: U701.2 (~RE), U701.3 (DE); also elsewhere on the board
/RS485/UART4_RX_M1: U701.1 (R); also elsewhere on the board
/RS485/UART4_TX_M1: U701.4 (D); also elsewhere on the board
GND: U701.5 (GND), U702.5 (GND); also elsewhere on the board
RS0+: U701.6 (A); also elsewhere on the board
RS0-: U701.7 (B); also elsewhere on the board
RS1+: U702.6 (A); also elsewhere on the board
RS1-: U702.7 (B); also elsewhere on the board

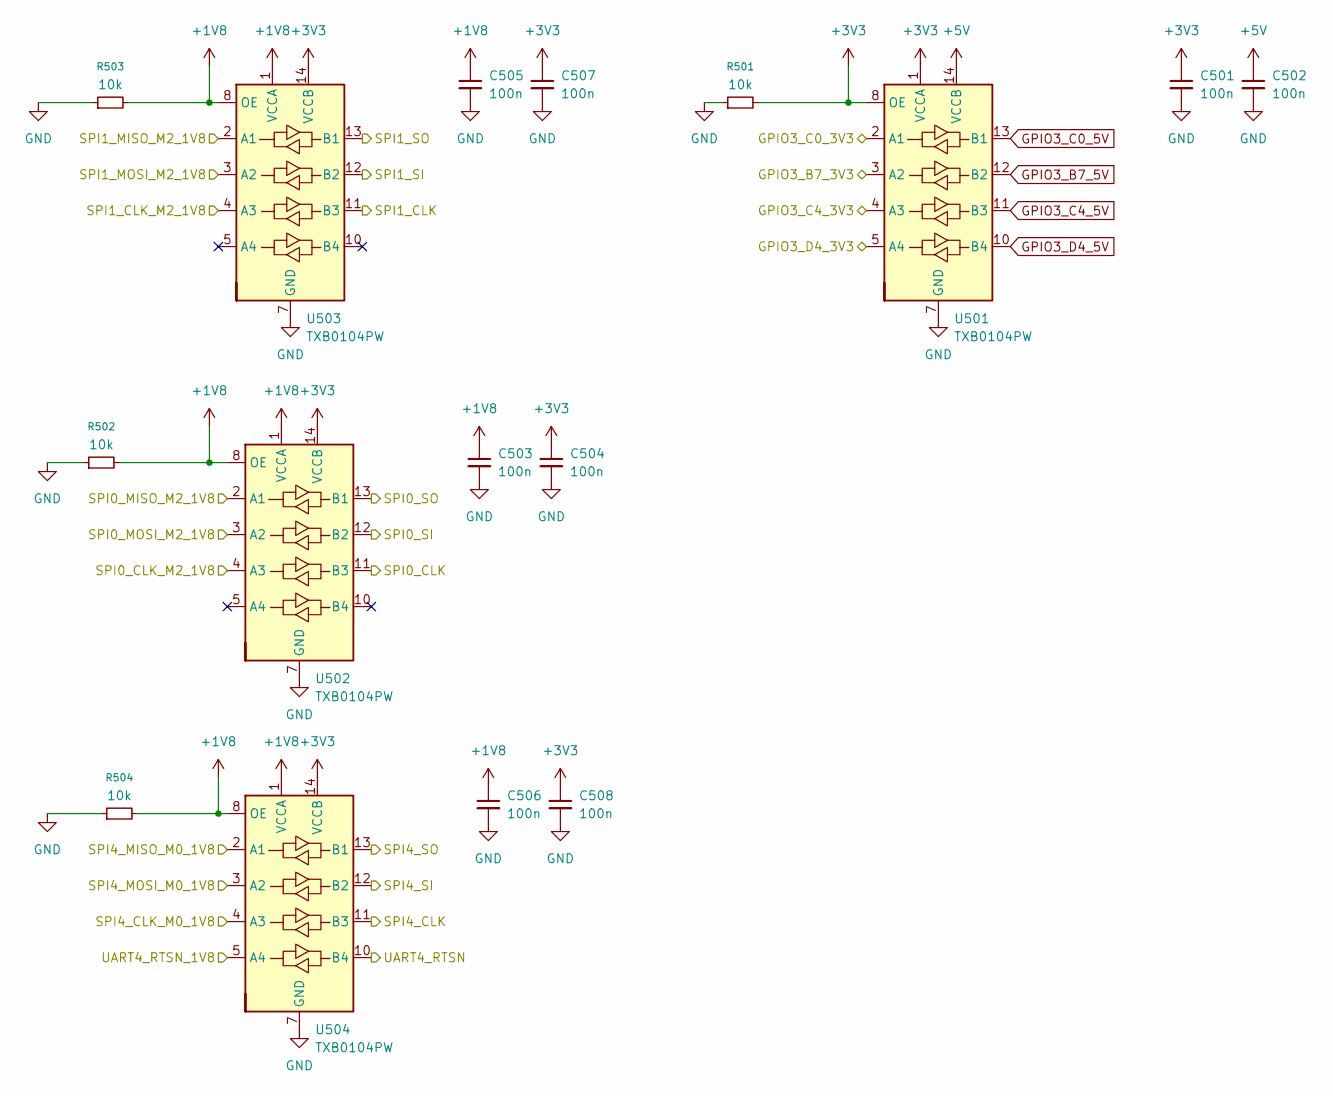
[picture p12: schematic TTL_SHIFT.kicad_sch]

Parts:
C501, C502, C503, C504, C505, C506, C507, C508: 100n; C_0402_1005Metric; LCSC C77020
R501, R502, R503, R504: 10k; R_0402_1005Metric; LCSC C190095
U501, U502, U503, U504: TXB0104PW; TSSOP-14_4.4x5mm_P0.65mm; LCSC C60708

Connections:
+1V8: C503.1, C505.1, C506.1, R502.2, R503.2, R504.2, U502.1 (VCCA), U502.8 (OE), U503.1 (VCCA), U503.8 (OE), U504.1 (VCCA), U504.8 (OE); also elsewhere on the board
+3V3: C501.1, C504.1, C507.1, C508.1, R501.2, U501.1 (VCCA), U501.8 (OE), U502.14 (VCCB), U503.14 (VCCB), U504.14 (VCCB); also elsewhere on the board
+5V: C502.1, U501.14 (VCCB); also elsewhere on the board
/J1/GPIO3_B7_3V3: U501.3 (A2); also elsewhere on the board
/J1/GPIO3_C0_3V3: U501.2 (A1); also elsewhere on the board
/J1/GPIO3_C4_3V3: U501.4 (A3); also elsewhere on the board
/J1/GPIO3_D4_3V3: U501.5 (A4); also elsewhere on the board
/J1/SPI1_CLK_M2_1V8: U503.4 (A3); also elsewhere on the board
/J1/SPI1_MISO_M2_1V8: U503.2 (A1); also elsewhere on the board
/J1/SPI1_MOSI_M2_1V8: U503.3 (A2); also elsewhere on the board
/J1/SPI4_MISO_M0_1V8: U504.2 (A1); also elsewhere on the board
/J1/SPI4_MOSI_M0_1V8: U504.3 (A2); also elsewhere on the board
/RS485/UART4_RTSN: U504.10 (B4); also elsewhere on the board
/SPI-CAN/SPI0_CLK: U502.11 (B3); also elsewhere on the board
/SPI-CAN/SPI0_SI: U502.12 (B2); also elsewhere on the board
/SPI-CAN/SPI0_SO: U502.13 (B1); also elsewhere on the board
/SPI-CAN/SPI1_CLK: U503.11 (B3); also elsewhere on the board
/SPI-CAN/SPI1_SI: U503.12 (B2); also elsewhere on the board
/SPI-CAN/SPI1_SO: U503.13 (B1); also elsewhere on the board
/SPI-CAN/SPI4_CLK: U504.11 (B3); also elsewhere on the board
/SPI-CAN/SPI4_SI: U504.12 (B2); also elsewhere on the board
/SPI-CAN/SPI4_SO: U504.13 (B1); also elsewhere on the board
/TTL-SHIFT/SPI0_CLK_M2_1V8: U502.4 (A3); also elsewhere on the board
/TTL-SHIFT/SPI0_MISO_M2_1V8: U502.2 (A1); also elsewhere on the board
/TTL-SHIFT/SPI0_MOSI_M2_1V8: U502.3 (A2); also elsewhere on the board
/TTL-SHIFT/SPI4_CLK_M0_1V8: U504.4 (A3); also elsewhere on the board
/TTL-SHIFT/UART4_RTSN_1V8: U504.5 (A4); also elsewhere on the board
GND: C501.2, C502.2, C503.2, C504.2, C505.2, C506.2, C507.2, C508.2, R501.1, R502.1, R503.1, R504.1, U501.7 (GND), U502.7 (GND), U503.7 (GND), U504.7 (GND); also elsewhere on the board
GPIO3_B7_5V: U501.12 (B2); also elsewhere on the board
GPIO3_C0_5V: U501.13 (B1); also elsewhere on the board
GPIO3_C4_5V: U501.11 (B3); also elsewhere on the board
GPIO3_D4_5V: U501.10 (B4); also elsewhere on the board

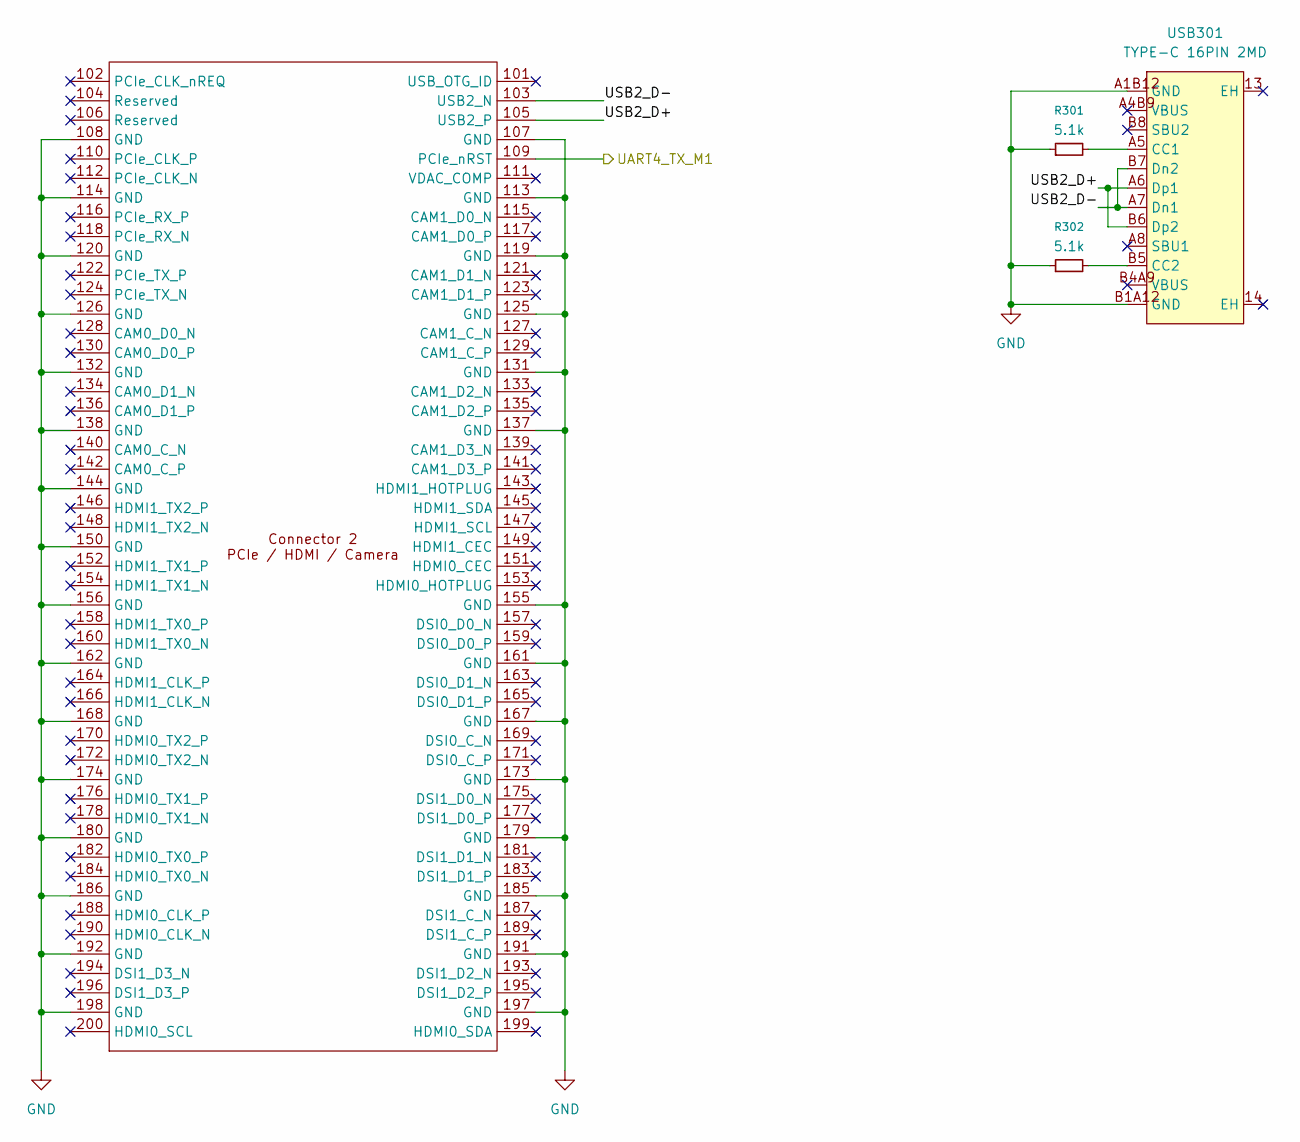
[picture p13: schematic cm5-u13b.kicad_sch]

Parts:
R301, R302: 5.1k; R_0402_1005Metric; LCSC C105872
U301: Hirose DF40C-100DS-0.4V; radxa_cm5_2; LCSC C597931
USB301: TYPE-C 16PIN 2MD; USB-C-SMD_TYPE-C-16PIN-2MD-073; MPN TYPE-C 16PIN 2MD(073); LCSC Part C2765186

Connections:
/RS485/UART4_TX_M1: U301.109 (PCIe_nRST); also elsewhere on the board
/U13B/USB2_D+: U301.105 (USB2_P), USB301.A6 (Dp1), USB301.B6 (Dp2)
/U13B/USB2_D-: U301.103 (USB2_N), USB301.A7 (Dn1), USB301.B7 (Dn2)
GND: R301.1, R302.1, U301.107 (GND), U301.108 (GND), U301.113 (GND), U301.114 (GND), U301.119 (GND), U301.120 (GND), U301.125 (GND), U301.126 (GND), U301.131 (GND), U301.132 (GND), U301.137 (GND), U301.138 (GND), U301.144 (GND), U301.150 (GND), U301.155 (GND), U301.156 (GND), U301.161 (GND), U301.162 (GND), U301.167 (GND), U301.168 (GND), U301.173 (GND), U301.174 (GND), U301.179 (GND), U301.180 (GND), U301.185 (GND), U301.186 (GND), U301.191 (GND), U301.192 (GND), U301.197 (GND), U301.198 (GND), USB301.A1B12 (GND), USB301.B1A12 (GND); also elsewhere on the board
unnamed: R301.2, USB301.A5 (CC1)
unnamed: R302.2, USB301.B5 (CC2)

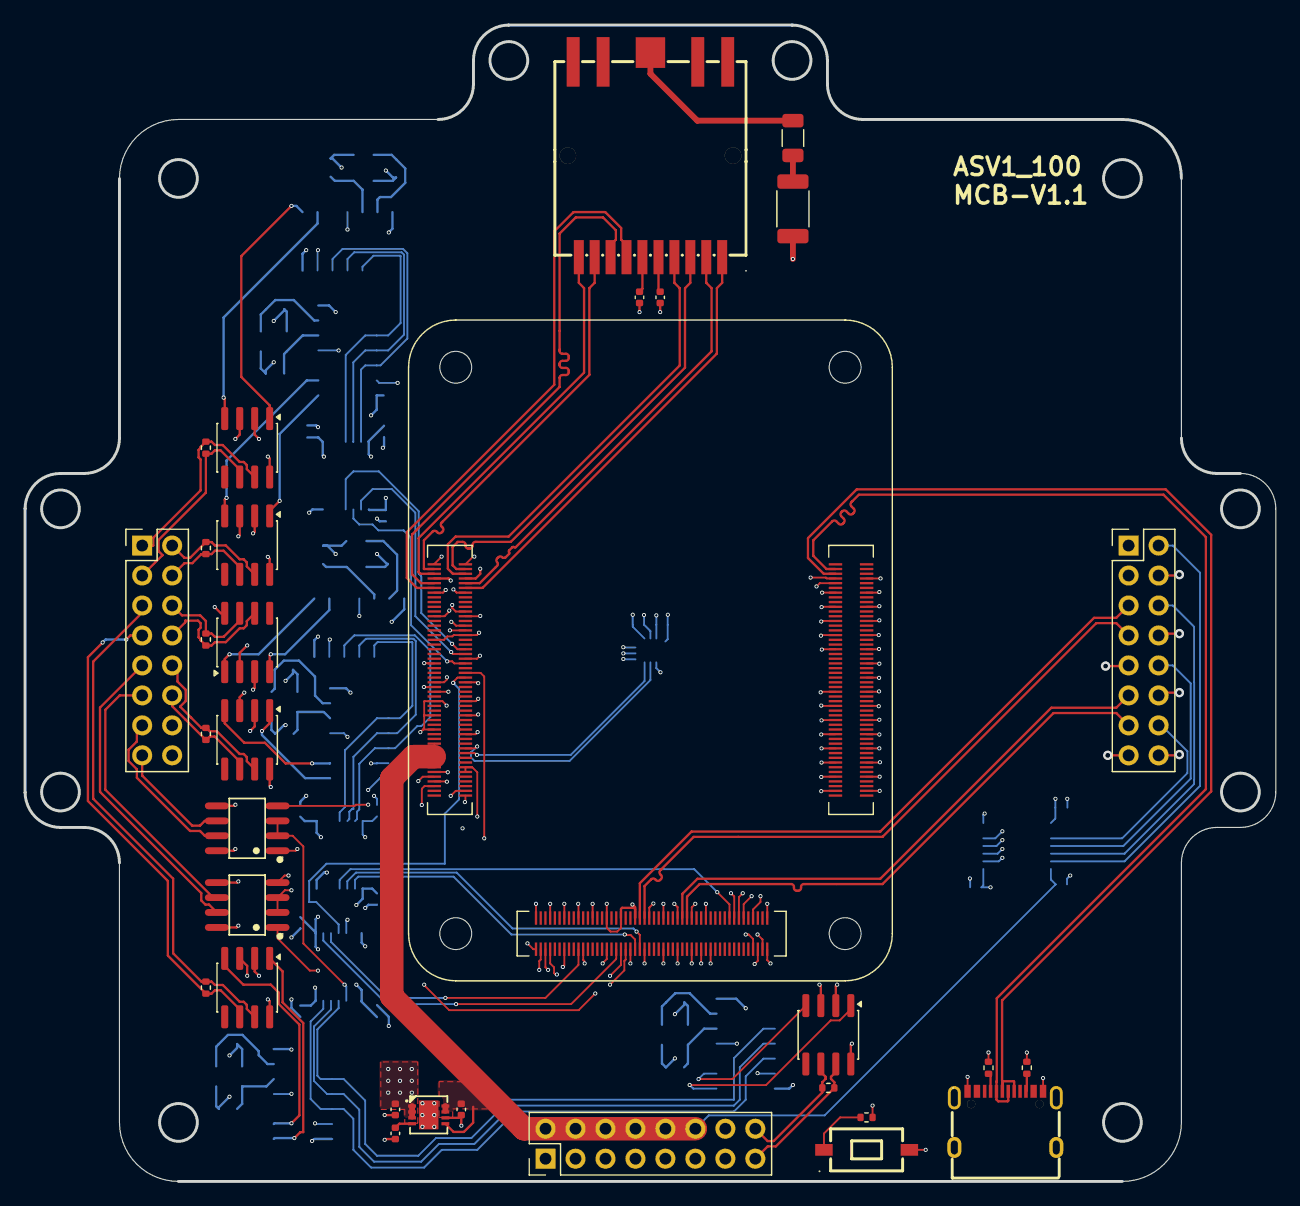
[picture p14: board electrical/motion_control/board/board.kicad_pcb from above]

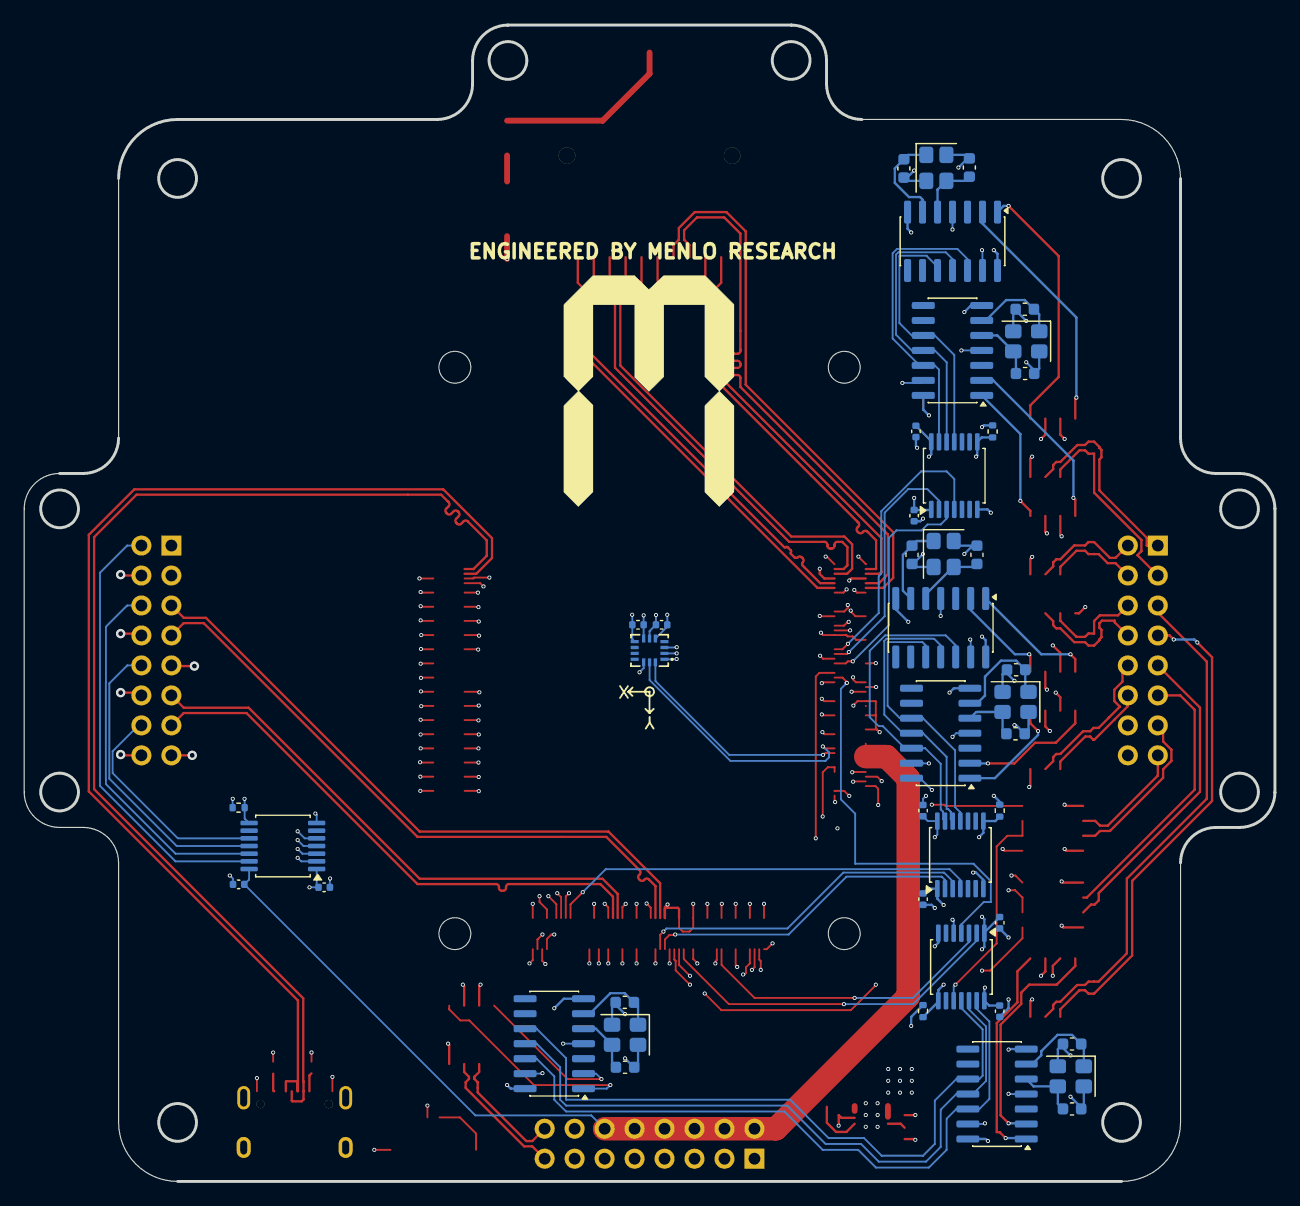
[picture p15: board electrical/motion_control/board/board.kicad_pcb from below]

Board: 4 copper layers, 106.0 x 98.0 mm, 77 parts (43 on the bottom side), 116 nets.
