osseus-mvp/asimov-1/(commit log)

2026-07-03 new boards, new device tree image
    [MCB-V1.0.step, PDB-V1.0.step, TTL_SHIFT.kicad_sch, board.kicad_pcb, board.kicad_sch, can.kicad_sch, cm5-j1.kicad_sch, cm5-u13a.kicad_sch]
2026-08-04 feat: add the declared system architecture and requirement register
    Three things the project already states about itself, written down where a
    machine can read them, plus the tests that hold them to it.
    tests/requirements/system-architecture.yaml is the system tree: the seven
    mechanical subassemblies from the naming convention and the fabrication
    manifest, the six MCB bus domains from the electrical port map and the
    device tree overlay, the Motion Control Board and the control software.
    Sourced from what the project declares, never reconstructed from part-name
    prefixes, and where a declaration has no artifact behind it the entry says
    so rather than guessing. Three gaps are recorded that way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
2026-08-04 docs: name the physical property each stakeholder requirement bounds
    Six L0 and L1 statements said what a number was without saying what kind
    of quantity it bounded — height without envelope, degrees of freedom
    without rotation, a passive joint without torque. Naming the property makes
    each statement scopeable on its own words, which is what lets a change to a
    mass or a torque reach the promises it can actually affect rather than all
    of them.
    Limits, units, comparators and ids are unchanged.
2026-08-04 feat: add the declared system architecture and requirement register (#1)
    * feat: add the declared system architecture and requirement register
    prefixes, and where a declaration has no artifact behind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
2026-08-04 docs: declare the CAN port to harness root join and the SML_316L class (#2)
    Two artifacts in this repository describe the same six CAN buses and never
    name each other: electrical/README.md gives ports C0-C5 with a purpose,
    electrical/wiring/wiring.yaml gives six "* Root SIG" connectors. Reading one
    into the other by matching words in their names would make a rename silently
    re-map the robot's buses, so the join is stated once by a human as
    `harness_root` on each bus domain, with the check that was run before
    asserting it recorded beside it.
    SML_316L carries 20 of the 170 fabrication manifest entries and had no
    directory-listing row, so it was the one fabrication class the mechanical
    README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
2026-08-04 ci: publish a JUnit report from the requirement tests
    The register names the tests that verify each requirement, but a run only
    published its overall conclusion, so a reader outside this repository could
    not tell a skipped test from a passing one. The workflow now writes a
    per-test record and uploads it on every run, red ones included.
    Also corrects the register header: six entries carry no `verifies`, not
    seven.
    [requirements.yaml]
2026-08-04 ci: keep the module path in the JUnit report
    xunit2, pytest's default family, filters the `file` attribute off every
    testcase element and leaves a dotted classname behind. Naming which test a
    result belongs to then means turning that classname back into a path, which
    is a guess. xunit1 states the path.
2026-08-04 Declare which rolled-up number REQ-L0-MASS's limit bounds (#3)
    The register says where the mass total is read from, in `measures`, and until
    now nothing said which number the 35 kg ceiling is compared against. `measures`
    cannot answer that: it is a pointer into a source artifact — a path and an
    XPath-ish expression — and reading it as anything else is a guess.
    So `constrains` is its own field, written <subject>@<property>:<aggregation>,
    and REQ-L0-MASS names the simulation model rather than SYS-ASV1. That
    difference is stated in the entry's basis: allocation says which part of the
    machine owns the promise, `constrains` says which number the limit is compared
    against, and the only artifa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
2026-08-04 mech: heavier pelvis casting for the revised battery mount
    The pelvis structure gains 3.3 kg after switching the battery mount to the
    thicker casting. Sim model updated to match the mechanical release.
2026-08-04 mech: cast-iron pelvis shell for the uprated battery mount
2026-08-04 mech: revert to the original pelvis casting
    The uprated battery mount is deferred to the next build, so the pelvis
    returns to the original aluminium casting and the sim model with it.
2026-08-04 mech: steel pelvis shell for the uprated battery mount
2026-08-04 mech: cast-aluminium pelvis shell to claw back battery-mount mass
2026-08-04 mech: thicker pelvis casting rib for the battery mount bolts
2026-08-04 mech: ductile-iron pelvis shell to carry the uprated battery mount
2026-08-04 mech: return the pelvis casting to the baseline shell
    Deliberate healthy baseline for a change-run rehearsal: the pelvis inertial
    mass goes back to 3.50691251175897 kg, putting the modelled link mass total at
    32.371277 kg against REQ-L0-MASS's 35 kg limit.
2026-08-04 mech: ductile-iron pelvis shell for the uprated battery mount
    The battery mount bolts tore out of the cast-aluminium pelvis in the drop rig,
    so the shell goes to ductile iron. The pelvis inertial mass rises from
    3.50691251175897 kg to 6.80691251175897 kg.
2026-08-04 mech: return the pelvis casting to the baseline shell
    The drop-rig fix moves to a bolted steel insert instead of an iron shell, so
    the pelvis inertial mass returns to 3.50691251175897 kg and the modelled link
    mass total to 32.371277 kg.
2026-08-04 mech: return the pelvis casting to the baseline shell
    Rehearsal reset: the pelvis inertial mass returns to 3.50691251175897 kg and
    the modelled link mass total to 32.371277 kg, inside REQ-L0-MASS.
2026-08-04 mech: return the pelvis casting to the baseline shell
    The healthy baseline this fork is left at between rehearsals: pelvis inertial
    mass 3.50691251175897 kg, modelled link mass total 32.371277 kg, inside
    REQ-L0-MASS's 35 kg limit.
2026-08-04 mech: ductile-iron pelvis shell for the uprated battery mount
2026-08-05 feat(register): bind the six actuator limits asimov-mjlab now publishes as data (#9)
    Fourteen entries of this register bound a number that lives in asimov-mjlab
    and none of them could be checked, because those numbers were in a Python
    module, a compiled model or a README table rather than in data.
    osseus-mvp/asimov-mjlab#2 publishes actuator_parameters.yaml: the constants
    named, with their units and their joints, and no numbers restated. Six of the
    fourteen can therefore be compared against a real value now, and they gain a
    `constrains` declaration: the five REQ-L2-EFFORT-* against their own
    actuator's maximum effort limit, and REQ-L2-DAMPING-CEILING against the
    maximum damping across every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
2026-08-13 Update sim-model with latest meshes, add URDF (#14)
    [ANKLE_B_NEW.STL, LEFT_ANKLE_B.STL, LEFT_TOE.STL, RIGHT_ANKLE_B.STL, RIGHT_TOE.STL, asimov_1.urdf]
2026-08-14 PCB for the head V0 (#12)
    * PCB for the head V0
    * Fixed C36 placement
    [head_board.epro]
